CyberHooves/0000.0129/README.md

# 0000.0129
Isolated half-bridge gate driver for IGBTs or MOSFETs
