CyberHooves/0000.0129/Pinouts.ods

Sheet: J1
Pin | Name | Type | Function
1 | GND | Power | Ground
2 | RDY_H | Output, open-drain | High-side driver ready
3 | GND | Power | Ground
4 | /FLT_H | Output, open-drain | High-side driver fault
5 | GND | Power | Ground
6 | APWM_H | Output | PWM output for high-side analogue/ASC input
7 | +12V | Power | +12V gate supply
8 | +12V | Power | +12V gate supply
9 | GND | Power | Ground
10 | IN+ | Input | Gate drive input, high for high-side on, low-side off
11 | GND | Power | Ground
12 | IN- | Input | Gate drive input, high for low-side on, high-side off
13 | GND | Input | Ground
14 | /RST | Input | Reset gate drivers
15 | GND | Power | Ground
16 | LOOP0 | Passive | Loopback to pin 18
17 | GND | Power | Ground
18 | LOOP1 | Passive | Loopback from pin 16
19 | GND | Power | Ground
20 | RDY_L | Output | Low-side driver ready
21 | GND | Power | Ground
22 | /FLT_L | Output | Low-side driver fault
23 | +5V | Power | +5V logic supply
24 | APWM_L | Output | PWM output for low-side analogue/ASC input

Sheet: J3
Pin | Name | Type | Function
1 | PHASE | Passive | Ground reference for the high-side driver
2 | DRV_H | Output | Gate drive of high-side switch
3 | CS_H | Input | Current sense input for high-side swith
4 | AIN_H | Input | Analogue input referenced to pin 1
5 | NC | NC | No connection.
6 | DESAT | Input | Connection to the emitter of the high-side switch for desaturation detection
7 | NC | NC | No connection.
8 | GND | Passive | Ground reference for the low-side switch
9 | DRV_L | Output | Gate drive of low-side switch
10 | CS_L | Input | Current sense input for low-side swith
11 | AIN_L | Input | Analogue input referenced to pin 8
