CyberHooves/0000.0129/0000.0129.kicad_pcb

## KiCad design 0000.0129.kicad_pcb (2025-10-24)

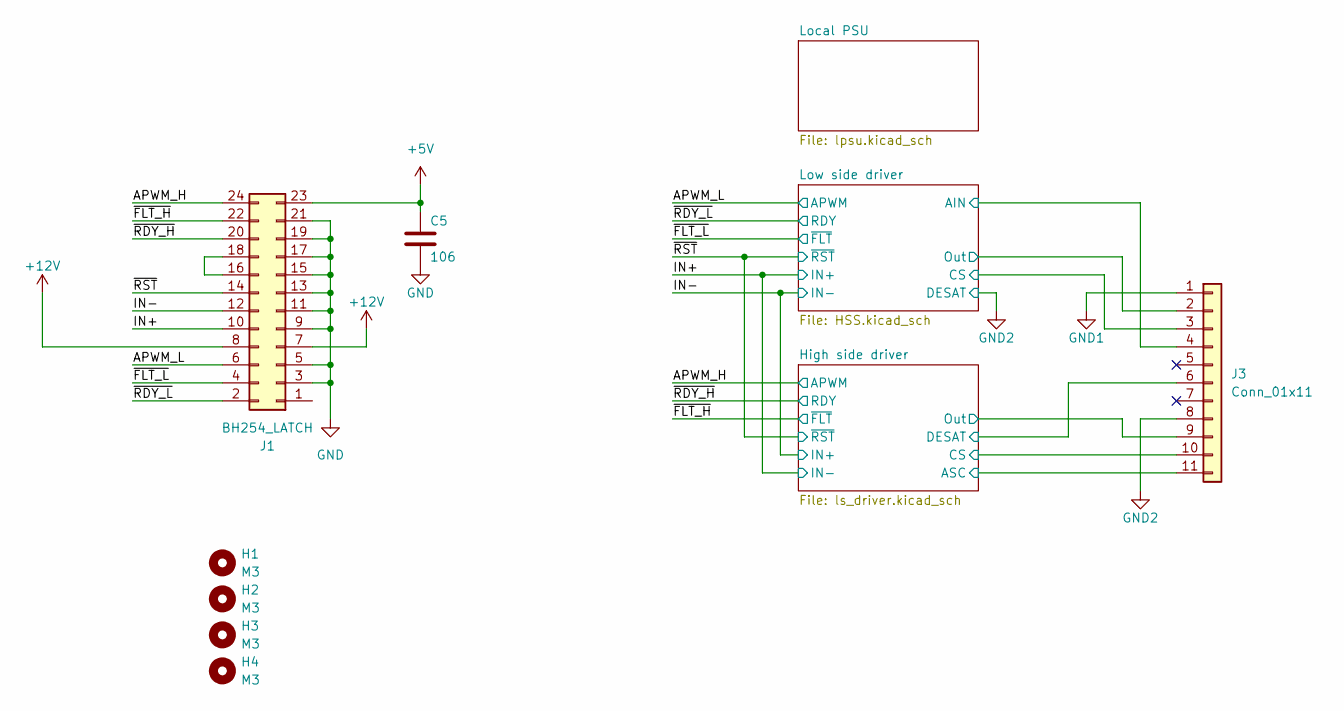
[picture p1: schematic 0000.0129.kicad_sch]

Parts:
C5: 106; C_0805_2012Metric
H1, H2, H3, H4: M3; MountingHole_3.2mm_M3_Pad
J1: BH254_LATCH; IDC-Header_2x12_P2.54mm_Latch9.5mm_Vertical
J3: Conn_01x11; PhoenixContact_MC_1,5_11-GF-5.08_1x11_P5.08mm_Horizontal_Th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

Connections:
+5V: C5.1, J1.23; also elsewhere on the board
+12V: J1.7, J1.8; also elsewhere on the board
/APWM_H: J1.24; also elsewhere on the board
/APWM_L: J1.6; also elsewhere on the board
/High side driver/ASC: J3.11; also elsewhere on the board
/High side driver/CS: J3.10; also elsewhere on the board
/High side driver/DESAT: J3.6; also elsewhere on the board
/High side driver/Out: J3.9; also elsewhere on the board
/IN+: J1.10; also elsewhere on the board
/IN-: J1.12; also elsewhere on the board
/Low side driver/AIN: J3.4; also elsewhere on the board
/Low side driver/CS: J3.3; also elsewhere on the board
/Low side driver/Out: J3.2; also elsewhere on the board
/~FLT_H: J1.22; also elsewhere on the board
/~FLT_L: J1.4; also elsewhere on the board
/~RDY_H: J1.20; also elsewhere on the board
/~RDY_L: J1.2; also elsewhere on the board
/~RST: J1.14; also elsewhere on the board
GND: C5.2, J1.3, J1.5, J1.9, J1.11, J1.13, J1.15, J1.17, J1.19, J1.21; also elsewhere on the board
GND1: J3.1; also elsewhere on the board
GND2: J3.8; also elsewhere on the board
unnamed: J1.16, J1.18

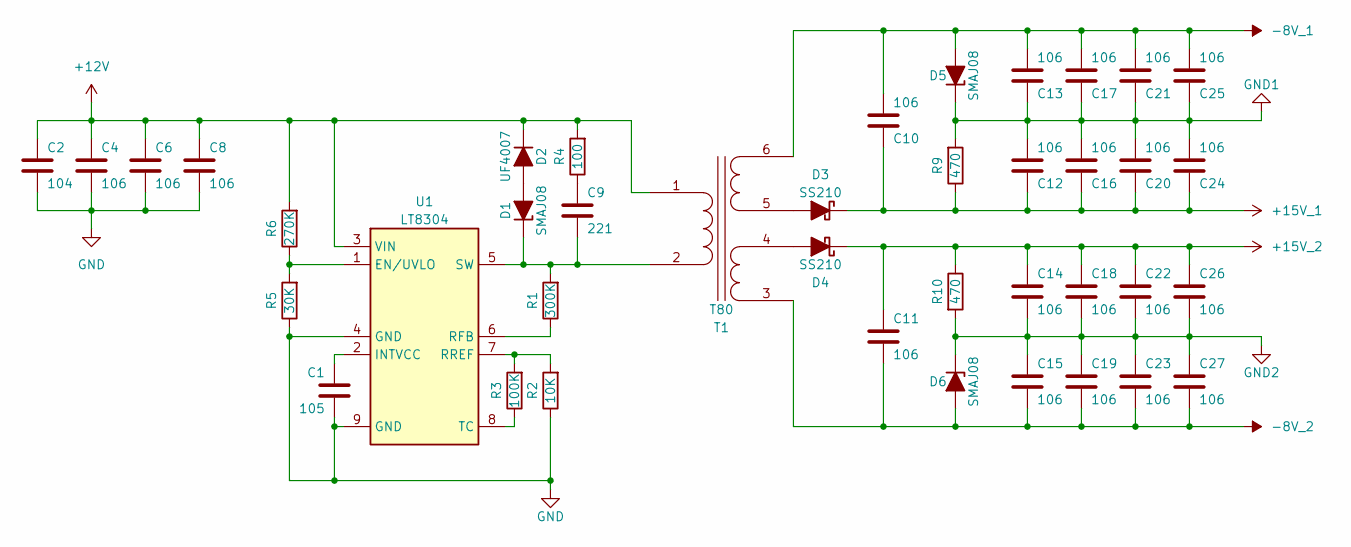
[picture p2: schematic lpsu.kicad_sch]

Parts:
C1: 105; C_0805_2012Metric
C2: 104; R_0805_2012Metric
C4, C6, C8, C10, C11, C12, C13, C14, C15, C16, C17, C18, C19, C20, C21, C22, C23, C24, C25, C26, C27: 106; C_1210_3225Metric
C9: 221; C_0805_2012Metric
D1, D5, D6: SMAJ08; D_SMA
D2: UF4007; D_SOD-123
D3, D4: SS210; D_SMB
R1: 300K; R_0805_2012Metric
R2: 10K; R_0805_2012Metric
R3: 100K; R_0805_2012Metric
R4: 100; R_2512_6332Metric
R5: 30K; R_0805_2012Metric
R6: 270K; R_0805_2012Metric
R9, R10: 470; R_1210_3225Metric
T1: T80; TRANSFORMER_T80_6P_01_H
U1: LT8304; SOIC-8-1EP_3.9x4.9mm_P1.27mm_EP2.41x3.3mm

Connections:
+12V: C2.1, C4.1, C6.1, C8.1, D2.1 (K), R4.2, R6.2, T1.1 (AB), U1.3 (VIN); also elsewhere on the board
+15V_1: C10.1, C12.1, C16.1, C20.1, C24.1, D3.1 (K), R9.1; also elsewhere on the board
+15V_2: C11.1, C14.1, C18.1, C22.1, C26.1, D4.1 (K), R10.1; also elsewhere on the board
-8V_1: C10.2, C13.2, C17.2, C21.2, C25.2, D5.2 (A), T1.6 (SD); also elsewhere on the board
-8V_2: C11.2, C15.2, C19.2, C23.2, C27.2, D6.2 (A), T1.3 (SA); also elsewhere on the board
GND: C1.2, C2.2, C4.2, C6.2, C8.2, R2.1, R5.1, U1.4 (GND), U1.9 (GND); also elsewhere on the board
GND1: C12.2, C13.1, C16.2, C17.1, C20.2, C21.1, C24.2, C25.1, D5.1 (K), R9.2; also elsewhere on the board
GND2: C14.2, C15.1, C18.2, C19.1, C22.2, C23.1, C26.2, C27.1, D6.1 (K), R10.2; also elsewhere on the board
unnamed: C9.1, R4.1
unnamed: D1.2 (A), D2.2 (A)
unnamed: C9.2, D1.1 (K), R1.2, T1.2 (AA), U1.5 (SW)
unnamed: D3.2 (A), T1.5 (SC)
unnamed: D4.2 (A), T1.4 (SB)
unnamed: R5.2, R6.1, U1.1 (EN/UVLO)
unnamed: C1.1, U1.2 (INTVCC)
unnamed: R1.1, U1.6 (RFB)
unnamed: R2.2, R3.2, U1.7 (RREF)
unnamed: R3.1, U1.8 (TC)

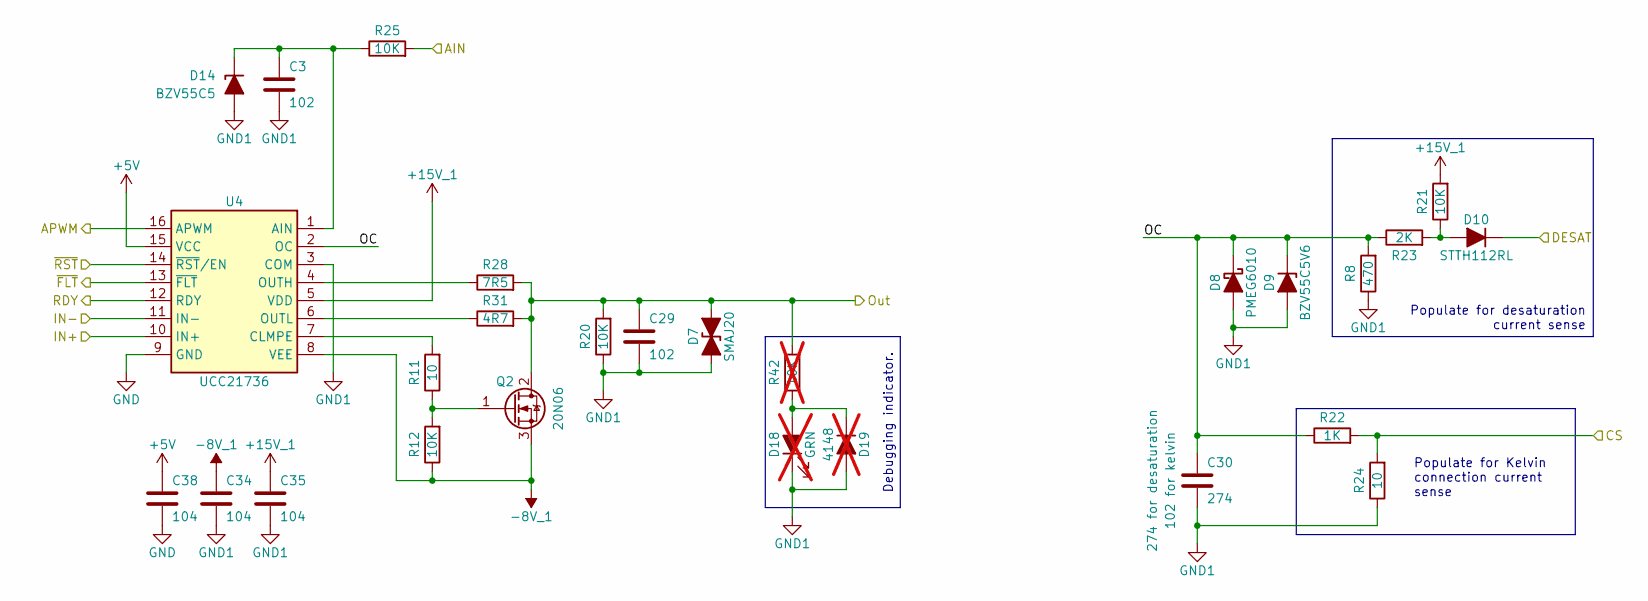
[picture p3: schematic HSS.kicad_sch]

Parts:
C3, C29: 102; C_0805_2012Metric
C30: 274; C_0805_2012Metric
C34, C35, C38: 104; C_0805_2012Metric
D7: SMAJ20; D_SMA
D8: PMEG6010; D_SOD-123
D9: BZV55C5V6; D_SOD-123
D10: STTH112RL; D_DO-41_SOD81_P10.16mm_Horizontal
D14: BZV55C5; D_SOD-123
D18: GRN; LED_D3.0mm; not fitted
D19: 4148; D_SOD-123; not fitted
Q2: 20N06; TO-252-2
R8: 470; R_0805_2012Metric
R11: 10; R_0805_2012Metric
R12, R20, R21: 10K; R_0805_2012Metric
R22: 1K; R_0805_2012Metric
R23: 2K; R_0805_2012Metric
R24: 10; R_2512_6332Metric
R25: 10K; R_1210_3225Metric
R28: 7R5; R_Axial_DIN0617_L17.0mm_D6.0mm_P20.32mm_Horizontal
R31: 4R7; R_Axial_DIN0617_L17.0mm_D6.0mm_P20.32mm_Horizontal
R42: 10K; R_0805_2012Metric; not fitted
U4: UCC21736; SOIC-16W_7.5x10.3mm_P1.27mm

Connections:
+5V: C38.1, U4.15 (VCC); also elsewhere on the board
+15V_1: C35.1, R21.2, U4.5 (VDD); also elsewhere on the board
-8V_1: C34.1, Q2.3 (S), R12.1, U4.8 (VEE); also elsewhere on the board
/APWM_L: U4.16 (APWM); also elsewhere on the board
/IN+: U4.10 (IN+); also elsewhere on the board
/IN-: U4.11 (IN-); also elsewhere on the board
/Low side driver/AIN: R25.2; also elsewhere on the board
/Low side driver/CS: R22.2, R24.2; also elsewhere on the board
/Low side driver/OC: C30.1, D8.1 (K), D9.1 (K), R8.2, R22.1, R23.1, U4.2 (OC)
/Low side driver/Out: C29.1, D7.2 (A2), Q2.2 (D), R20.2, R28.2, R31.2, R42.2; also elsewhere on the board
/~FLT_L: U4.13 (~FLT); also elsewhere on the board
/~RDY_L: U4.12 (RDY); also elsewhere on the board
/~RST: U4.14 (~RST/EN); also elsewhere on the board
GND: C38.2, U4.9 (GND); also elsewhere on the board
GND1: C3.2, C29.2, C30.2, C34.2, C35.2, D7.1 (A1), D8.2 (A), D9.2 (A), D14.2 (A), D18.1 (K), D19.2 (A), R8.1, R20.1, R24.1, U4.3 (COM); also elsewhere on the board
GND2: D10.1 (K); also elsewhere on the board
unnamed: D10.2 (A), R21.1, R23.2
unnamed: C3.1, D14.1 (K), R25.1, U4.1 (AIN)
unnamed: D18.2 (A), D19.1 (K), R42.1
unnamed: Q2.1 (G), R11.1, R12.2
unnamed: R11.2, U4.7 (CLMPE)
unnamed: R28.1, U4.4 (OUTH)
unnamed: R31.1, U4.6 (OUTL)

Notes on the sheet:
Populate for Kelvin connection current sense
Populate for desaturation current sense
Debugging indicator.

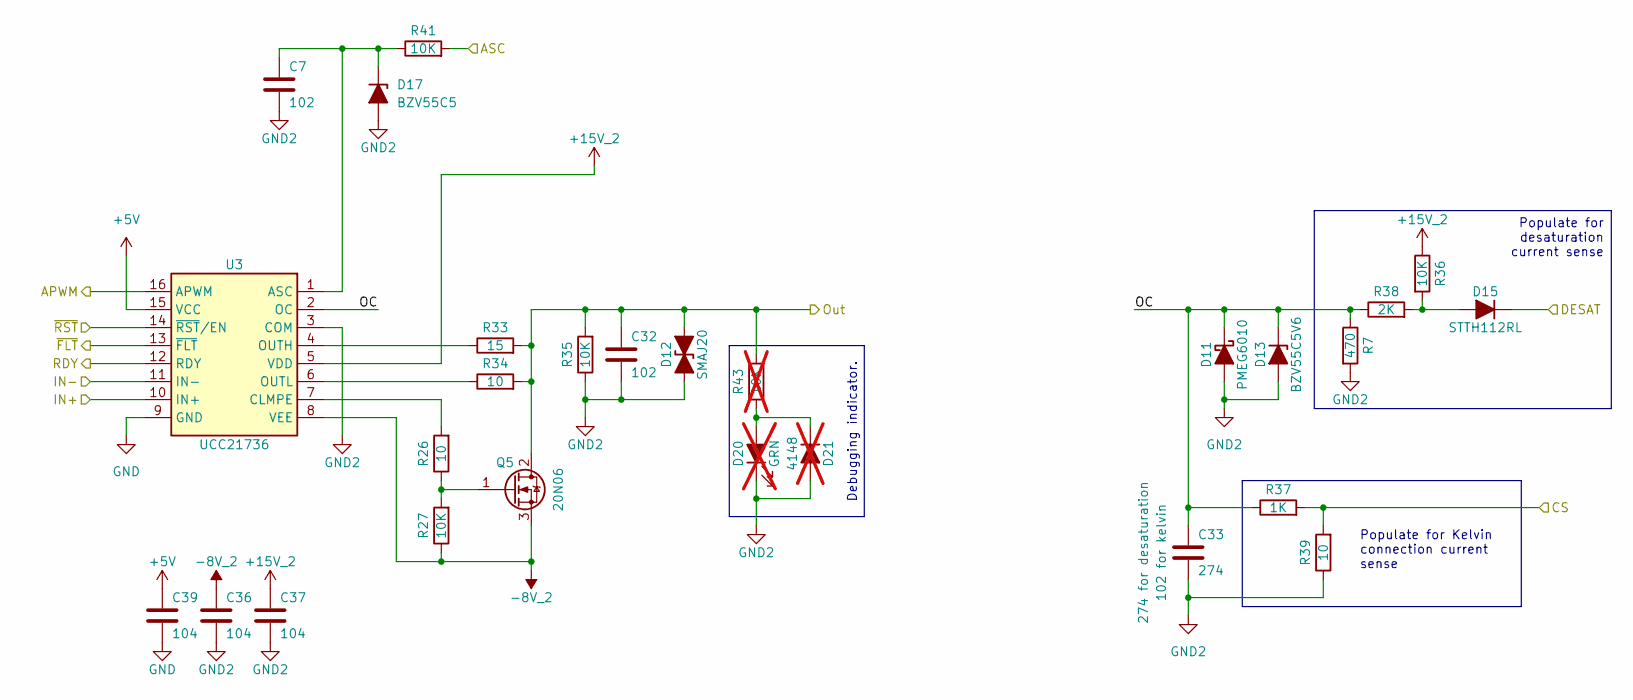
[picture p4: schematic ls_driver.kicad_sch]

Parts:
C7, C32: 102; C_0805_2012Metric
C33: 274; C_0805_2012Metric
C36, C37, C39: 104; C_0805_2012Metric
D11: PMEG6010; D_SOD-123
D12: SMAJ20; D_SMA
D13: BZV55C5V6; D_SOD-123
D15: STTH112RL; D_DO-41_SOD81_P10.16mm_Horizontal
D17: BZV55C5; D_SOD-123
D20: GRN; LED_D3.0mm; not fitted
D21: 4148; D_SOD-123; not fitted
Q5: 20N06; TO-252-2
R7: 470; R_0805_2012Metric
R26: 10; R_0805_2012Metric
R27, R35, R36: 10K; R_0805_2012Metric
R33: 15; R_Axial_DIN0617_L17.0mm_D6.0mm_P20.32mm_Horizontal
R34: 10; R_Axial_DIN0617_L17.0mm_D6.0mm_P20.32mm_Horizontal
R37: 1K; R_0805_2012Metric
R38: 2K; R_0805_2012Metric
R39: 10; R_2512_6332Metric
R41: 10K; R_1210_3225Metric
R43: 10K; R_0805_2012Metric; not fitted
U3: UCC21736; SOIC-16W_7.5x10.3mm_P1.27mm

Connections:
+5V: C39.1, U3.15 (VCC); also elsewhere on the board
+15V_2: C37.1, R36.1, U3.5 (VDD); also elsewhere on the board
-8V_2: C36.1, Q5.3 (S), R27.1, U3.8 (VEE); also elsewhere on the board
/APWM_H: U3.16 (APWM); also elsewhere on the board
/High side driver/ASC: R41.2; also elsewhere on the board
/High side driver/CS: R37.2, R39.2; also elsewhere on the board
/High side driver/DESAT: D15.1 (K); also elsewhere on the board
/High side driver/OC: C33.1, D11.1 (K), D13.1 (K), R7.1, R37.1, R38.1, U3.2 (OC)
/High side driver/Out: C32.1, D12.2 (A2), Q5.2 (D), R33.2, R34.2, R35.2, R43.2; also elsewhere on the board
/IN+: U3.11 (IN-); also elsewhere on the board
/IN-: U3.10 (IN+); also elsewhere on the board
/~FLT_H: U3.13 (~FLT); also elsewhere on the board
/~RDY_H: U3.12 (RDY); also elsewhere on the board
/~RST: U3.14 (~RST/EN); also elsewhere on the board
GND: C39.2, U3.9 (GND); also elsewhere on the board
GND2: C7.2, C32.2, C33.2, C36.2, C37.2, D11.2 (A), D12.1 (A1), D13.2 (A), D17.2 (A), D20.1 (K), D21.2 (A), R7.2, R35.1, R39.1, U3.3 (COM); also elsewhere on the board
unnamed: D15.2 (A), R36.2, R38.2
unnamed: C7.1, D17.1 (K), R41.1, U3.1 (ASC)
unnamed: D20.2 (A), D21.1 (K), R43.1
unnamed: Q5.1 (G), R26.1, R27.2
unnamed: R26.2, U3.7 (CLMPE)
unnamed: R33.1, U3.4 (OUTH)
unnamed: R34.1, U3.6 (OUTL)

Notes on the sheet:
Populate for Kelvin connection current sense
Debugging indicator.
Populate for desaturation current sense

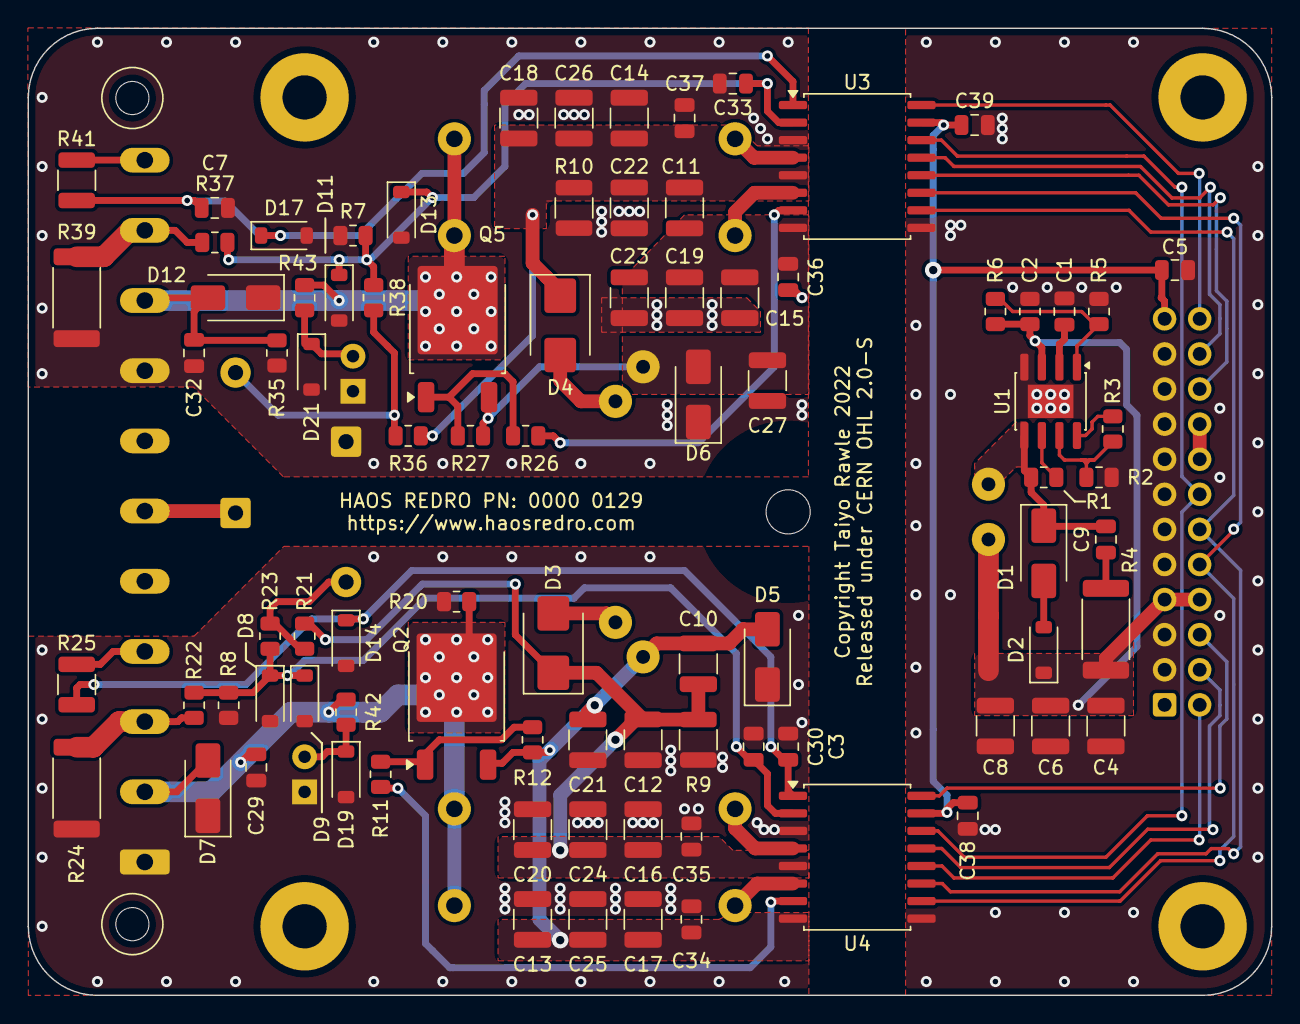
[picture p5: board 0000.0129.kicad_pcb from above]

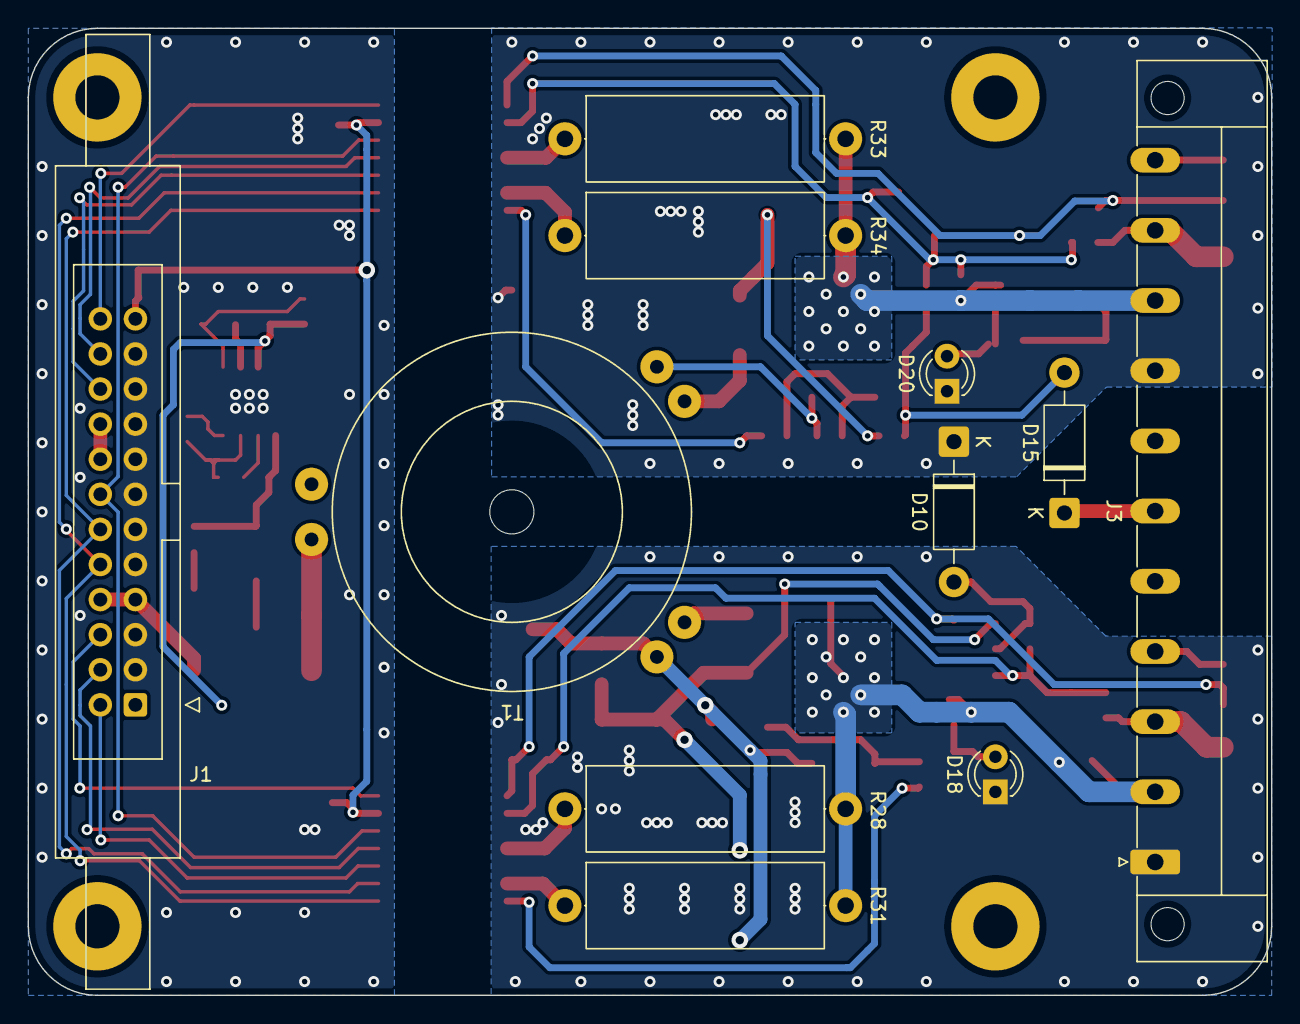
[picture p6: board 0000.0129.kicad_pcb from below]

Board: 2 copper layers, 90.0 x 70.0 mm, 101 parts (11 on the bottom side), 52 nets.
