CyberHooves/0000.0129/(notices)

Notices in the files:
0000.0129.kicad_pcb:
Copyright Taiyo Rawle 2022
Released under CERN OHL 2.0-S
